itdaniher/driver/driveher.brd.png

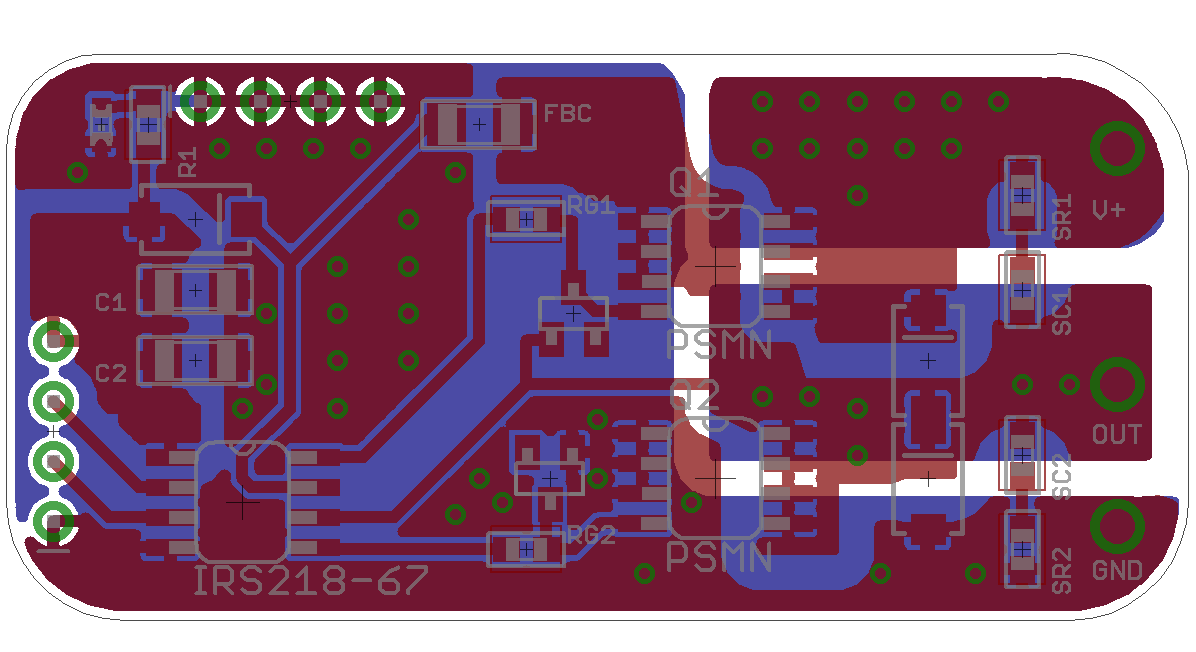
driveher.brd.png
