itdaniher/driver/driveher.sch.png

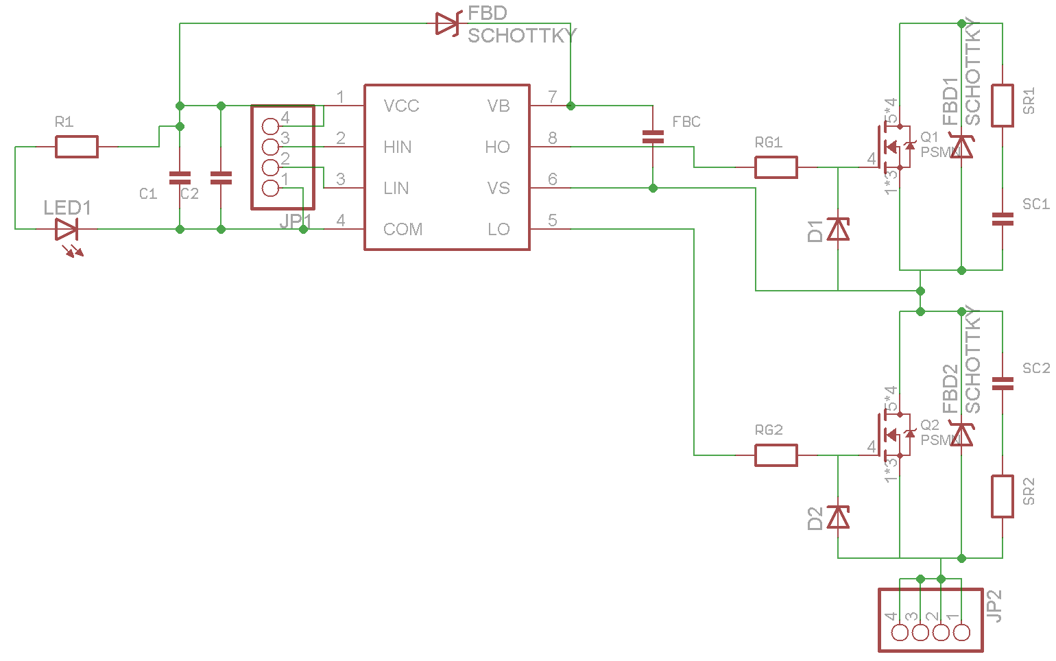
driveher.sch.png
