itdaniher/driver/driveher.brd

## EAGLE design driveher.brd (2013-05-30)

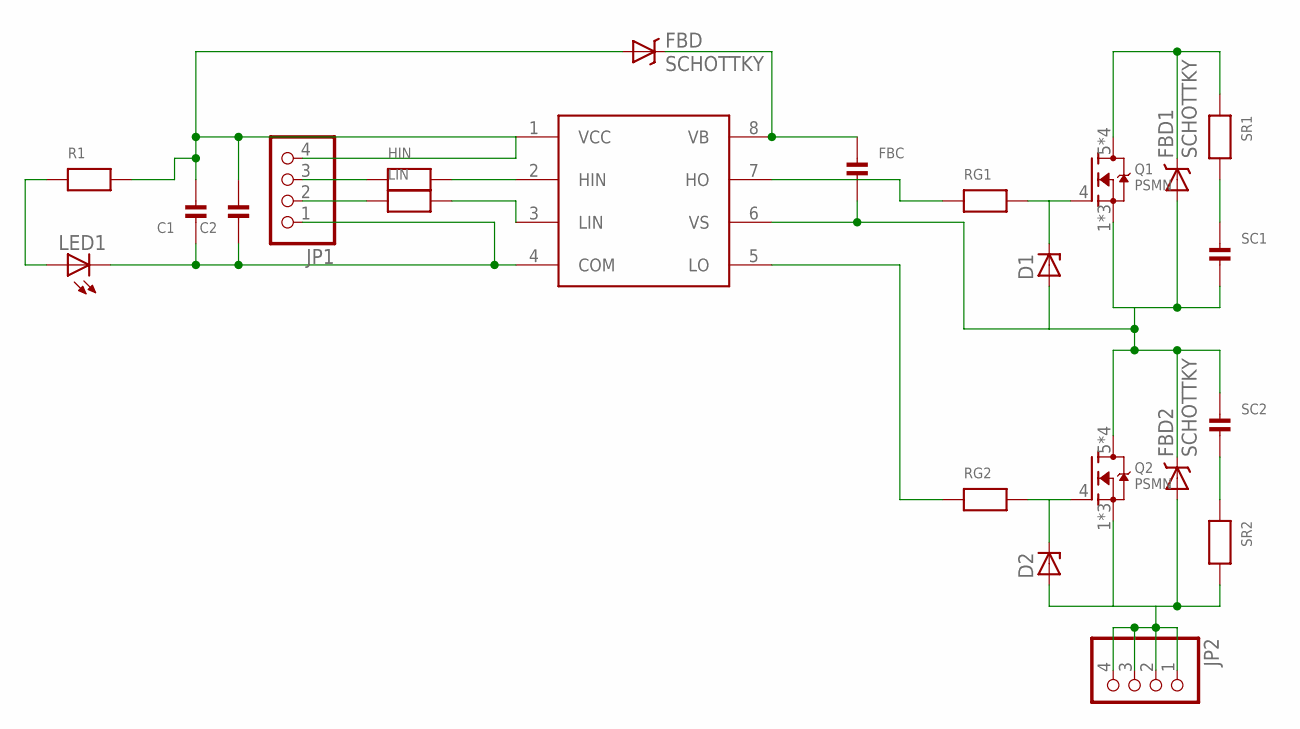
[picture p3: schematic driveher.sch]

Parts:
C1, C2: CAP_CERAMIC1206; 1206
D1, D2: ZENER-DIODESOT23; SOT23
FBC: CAP_CERAMIC1206; 1206
FBD, FBD1, FBD2: SCHOTTKY; SMA-DIODE
HIN: RESISTOR0603; 0603
JP1, JP2: HEADER-1X4ROUND; 1X04_ROUND
LED1: LEDCHIPLED_0603; CHIPLED_0603
LIN: RESISTOR0603; 0603
Q1, Q2: PSMN; SO-08
R1: RESISTOR0603; 0603
RG1, RG2: RESISTOR0603; 0603
SC1, SC2: CAP_CERAMIC0603; 0603
SR1, SR2: RESISTOR0603; 0603
U$1: IRS218-67; SO-08

Connections:
12V: C1.2, C2.2, FBD.A, JP1.4, R1.2, U$1.1 (VCC)
FLOAT: FBC.1, FBD.C, U$1.8 (VB)
G1: D1.3 (C), Q1.4 (G), RG1.2
G2: D2.3 (C), Q2.4 (G), RG2.2
GND: C1.1, C2.1, D2.1 (A), FBD2.A, JP1.1, JP2.1, JP2.2, JP2.3, JP2.4, LED1.C, Q2.1 (S), Q2.2 (S), Q2.3 (S), SR2.2, U$1.4 (COM)
HIN-P: HIN.2, U$1.2 (HIN)
HOUT: RG1.1, U$1.7 (HO)
LIN-P: LIN.2, U$1.3 (LIN)
LOUT: RG2.1, U$1.5 (LO)
unnamed: LED1.A, R1.1
unnamed: SC1.1, SR1.2
unnamed: HIN.1, JP1.3
unnamed: JP1.2, LIN.1
OUT: D1.1 (A), FBC.2, FBD1.A, FBD2.C, Q1.1 (S), Q1.2 (S), Q1.3 (S), Q2.5 (D), Q2.6 (D), Q2.7 (D), Q2.8 (D), SC1.2, SC2.1, U$1.6 (VS)
P2: SC2.2, SR2.1
V+: FBD1.C, Q1.5 (D), Q1.6 (D), Q1.7 (D), Q1.8 (D), SR1.1

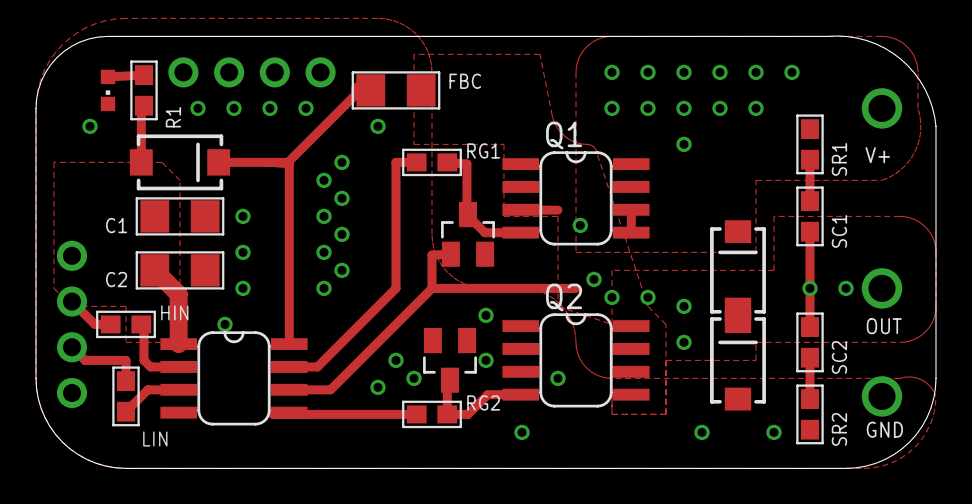
[picture p4: board driveher.brd from above]

Board: 2 copper layers, 50.0 x 24.0 mm, 23 parts (0 on the bottom side), 16 nets.
