itdaniher/driver/(commit log)

2013-04-25 initial commit of 1kw in 2" drive board
    [driveher.brd, driveher.sch, drivehersch.brd, drivehersch.sch]
2013-04-25 those do not belong there!
    [drivehersch.brd, drivehersch.sch]
2013-05-30 fixed ir25606 / '67 routing, beefed up trace b/t high side source & output, added input protect resistors
    [driveher.brd, driveher.sch]
